flavian112/internet_clock_hardware/(commit log)

2024-02-01 Renamed project
    [internet_clock_hardware.kicad_pcb, internet_clock_hardware.kicad_sch]
2024-02-01 Deleted old files
    [internet_clock_board.kicad_pcb, internet_clock_board.kicad_sch]
2024-02-01 Rev 1.0
    [internet_clock_hardware.kicad_pcb, internet_clock_hardware.kicad_sch]
2024-02-03 cosmetic improvements, measurements
    [internet_clock_hardware.kicad_pcb, internet_clock_hardware.kicad_sch]
2024-02-28 added 3d models
    [internet_clock_hardware.kicad_pcb, internet_clock_hardware.kicad_sch]
2024-02-29 fixed wrong pin numbering on pot (RV1)
    [internet_clock_hardware.kicad_pcb]
2024-02-29 added pot stp
    [internet_clock_hardware.kicad_pcb]
2024-02-29 gerber exports
    [internet_clock_hardware-B_Cu.gbr, internet_clock_hardware-B_Mask.gbr, internet_clock_hardware-B_Silkscreen.gbr, internet_clock_hardware-Edge_Cuts.gbr, internet_clock_hardware-F_Cu.gbr, internet_clock_hardware-F_Mask.gbr, internet_clock_hardware-F_Silkscreen.gbr, internet_clock_hardware-NPTH.drl]
